jerrywang1201/TahoeOS/images/back.jpg

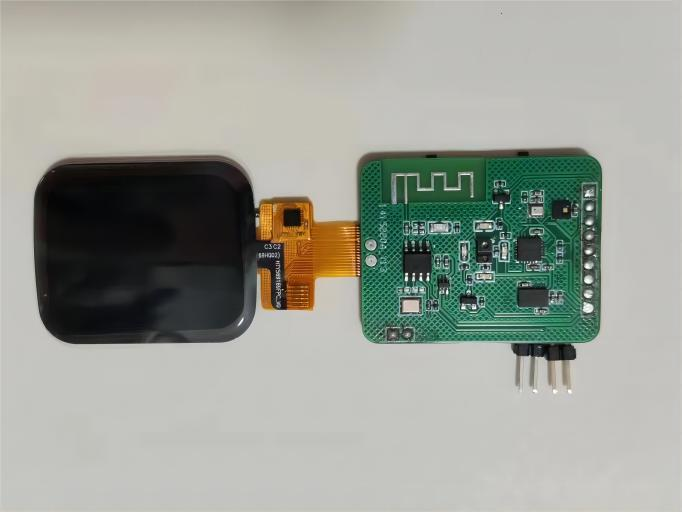
images/back.jpg
