jerrywang1201/TahoeOS/images/EM7028的测量曲线.jpg

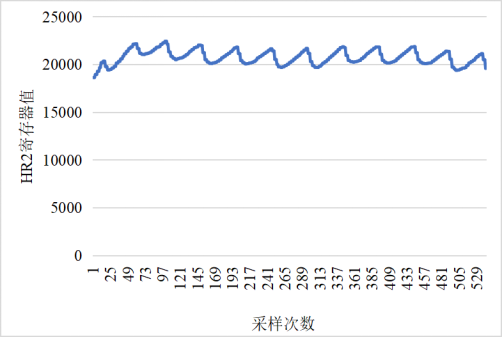
images/EM7028的测量曲线.jpg
