jerrywang1201/TahoeOS/images/front.jpg

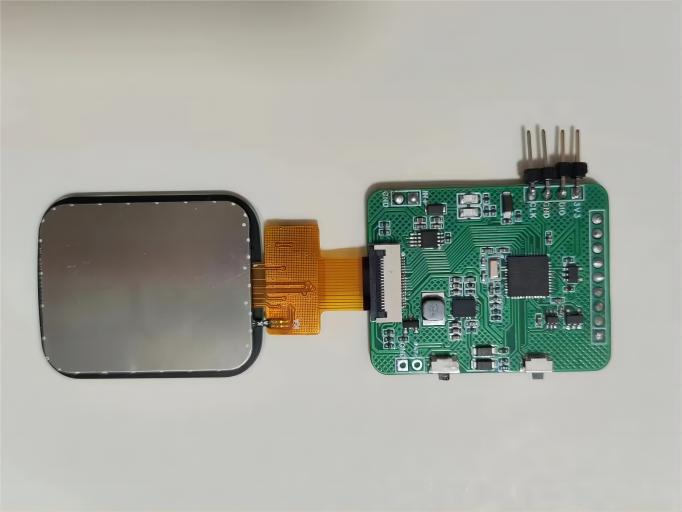
images/front.jpg
