jerrywang1201/TahoeOS/images/LVGL_sim.jpg

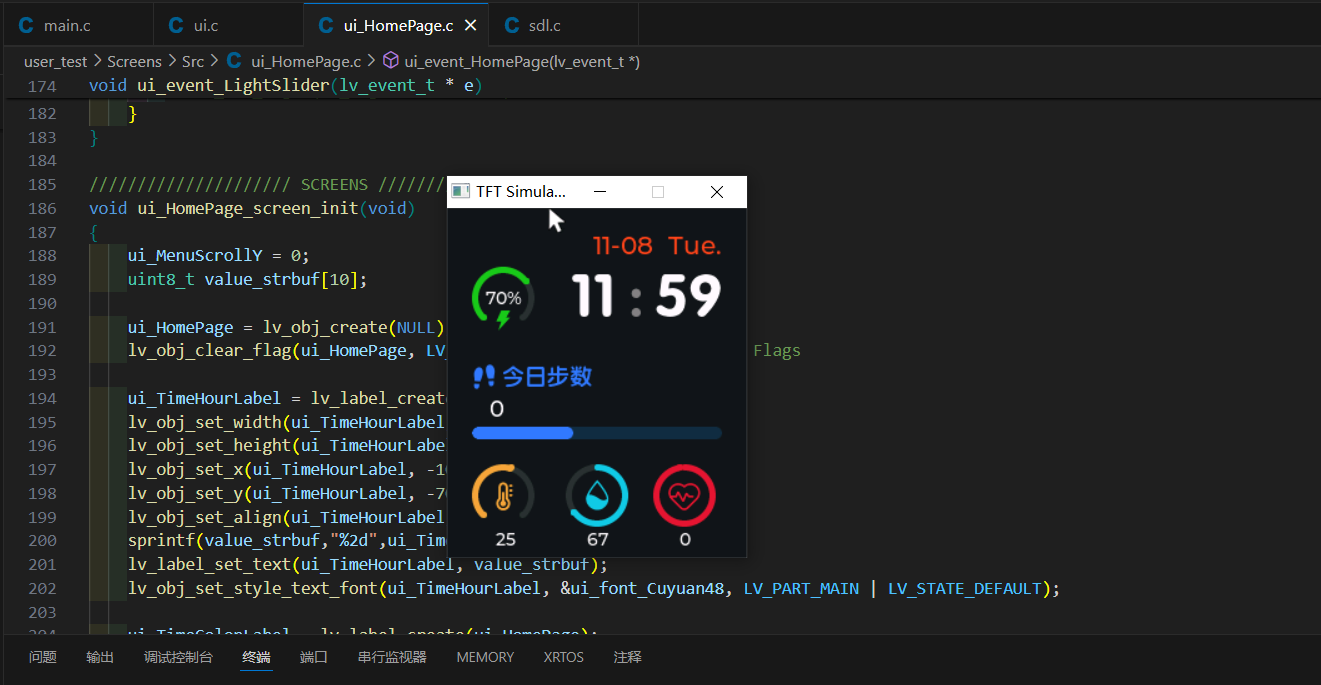
images/LVGL_sim.jpg
