jerrywang1201/TahoeOS/images/software structure.jpg

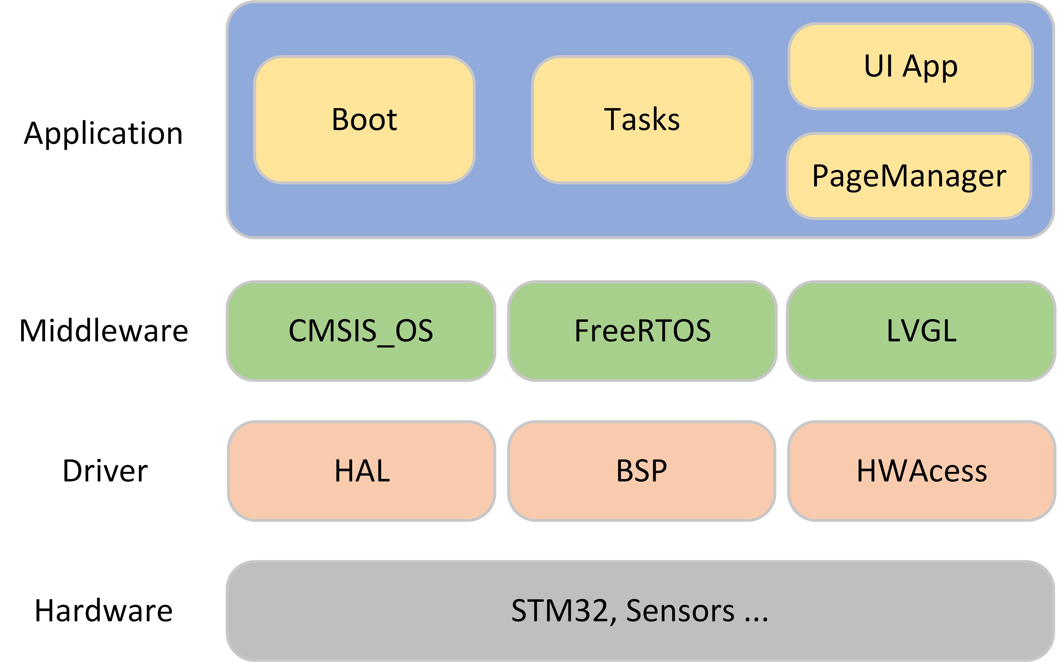
images/software structure.jpg
