jerrywang1201/TahoeOS/images/功能表.jpg

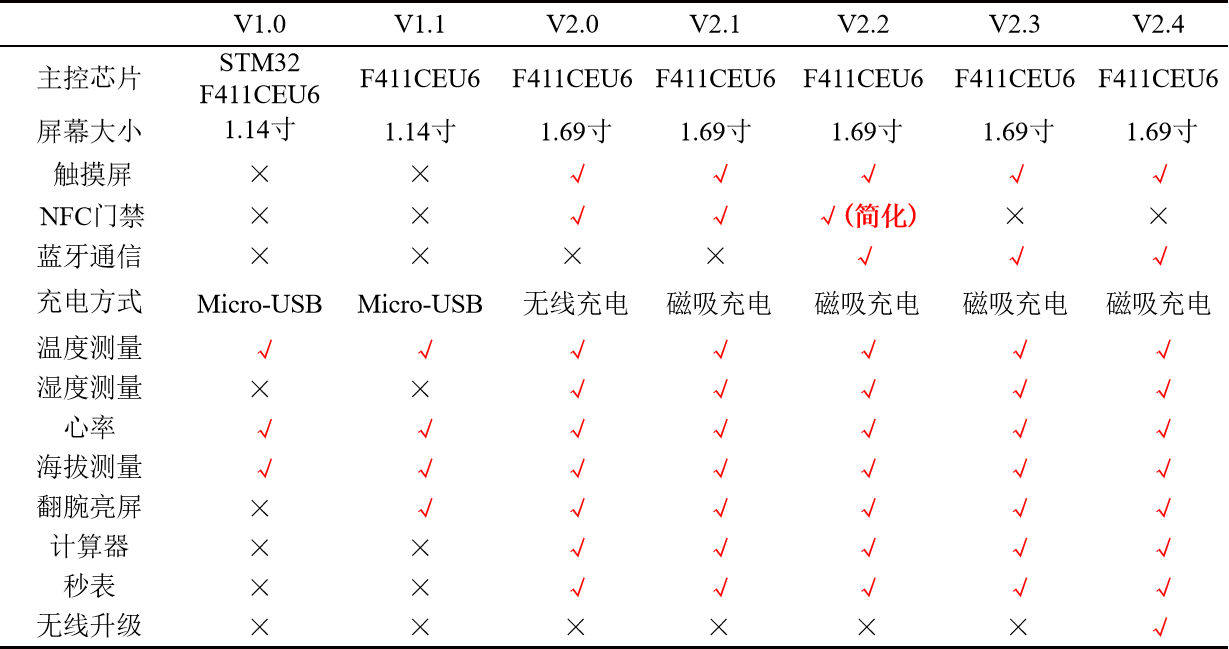
images/功能表.jpg
