jerrywang1201/TahoeOS/images/实物图2.png

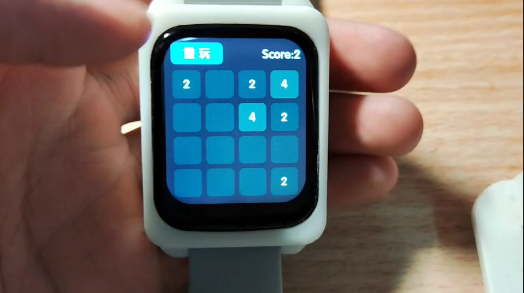
images/实物图2.png
