jerrywang1201/TahoeOS/images/实物图3.png

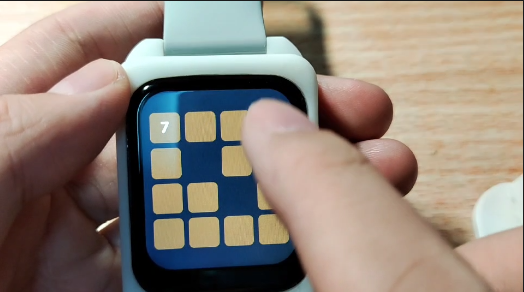
images/实物图3.png
