jerrywang1201/TahoeOS/images/心率实物图.png

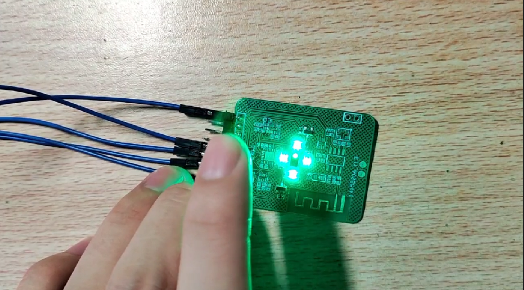
images/心率实物图.png
