jerrywang1201/TahoeOS/images/界面.jpg

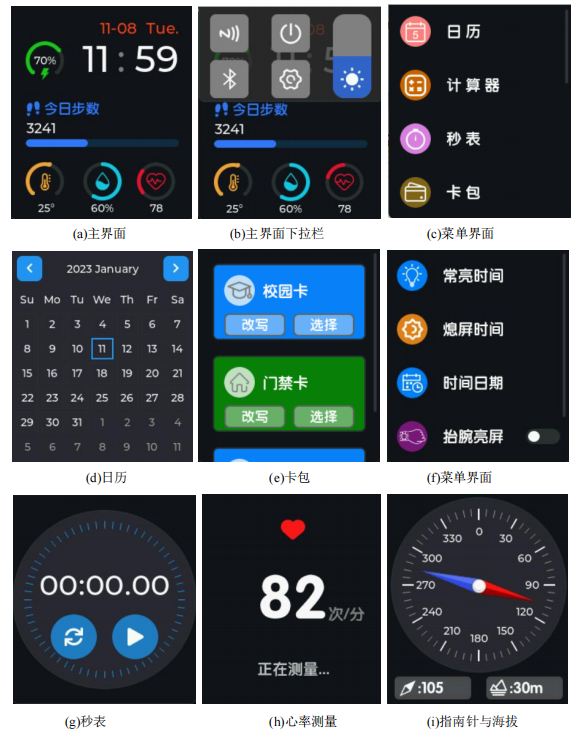
images/界面.jpg
