jerrywang1201/TahoeOS/images/计算.gif

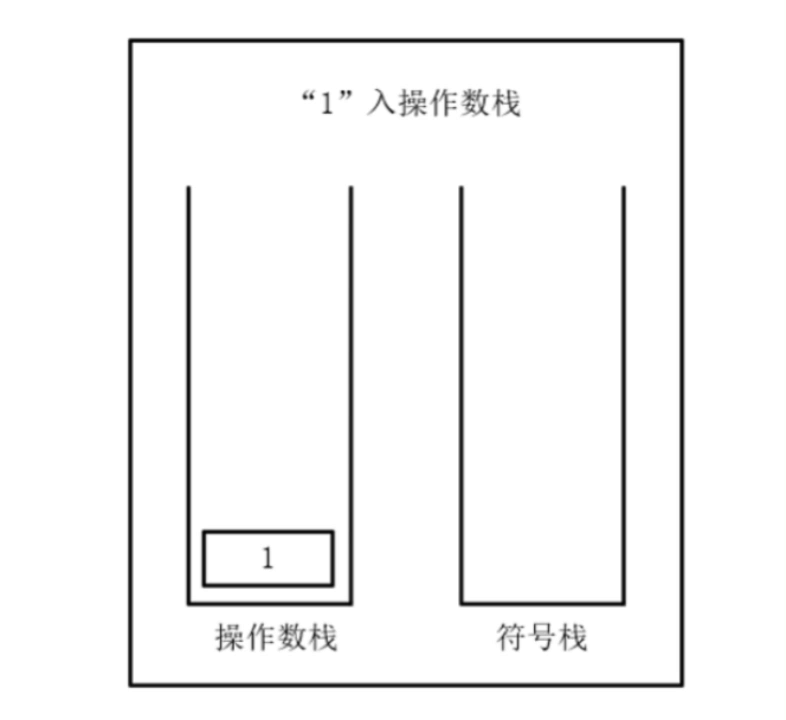
images/计算.gif
