jerrywang1201/TahoeOS/3D Modle/按键零件.STL

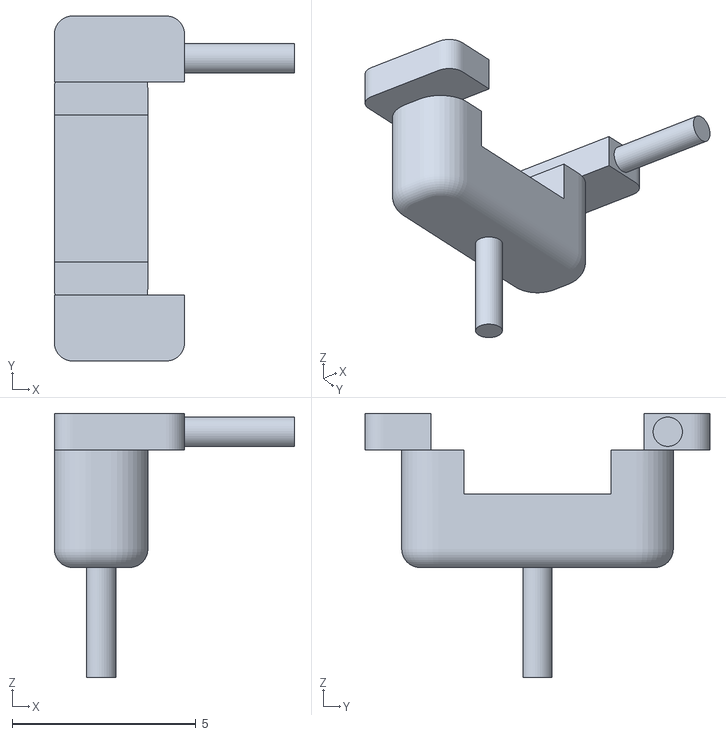
[picture p21: CAD file, 2025-12-08]
3D Modle/按键零件.STL
6.55 x 9.40 x 7.20
