jerrywang1201/TahoeOS/3D Modle/后壳零件.STL

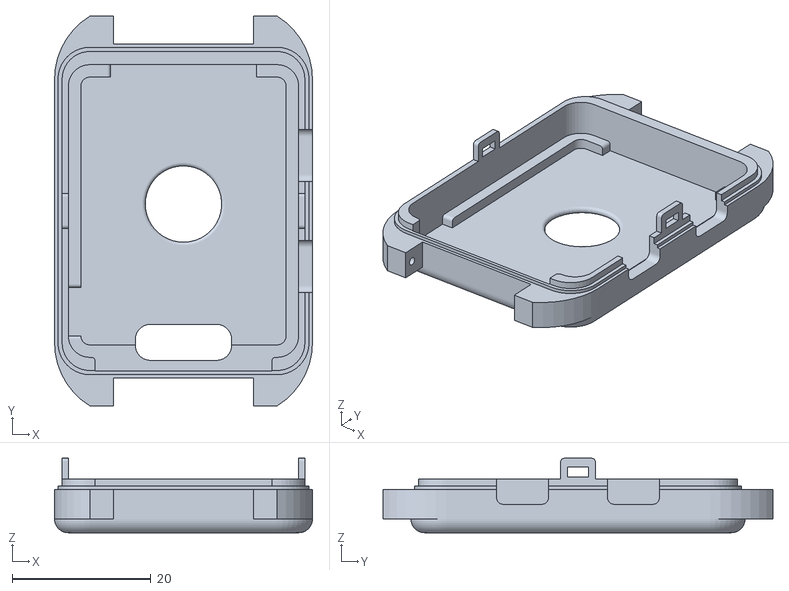
[picture p22: CAD file, 2025-12-08]
3D Modle/后壳零件.STL
37.2 x 56.2 x 10.8
