jerrywang1201/TahoeOS/3D Modle/前壳零件.STL

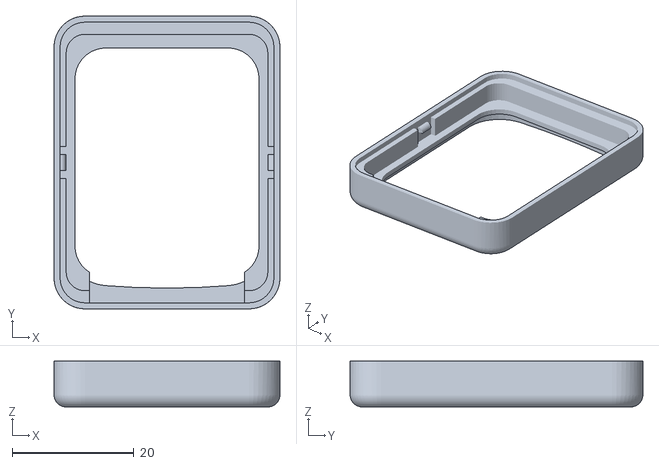
[picture p23: CAD file, 2025-12-08]
3D Modle/前壳零件.STL
37.2 x 48.2 x 7.55
