jerrywang1201/TahoeOS/Software/IAP_F411/Core/Src/main.c

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
/* Includes ------------------------------------------------------------------*/
#include "main.h"
#include "adc.h"
#include "spi.h"
#include "tim.h"
#include "usart.h"
#include "gpio.h"

/* USER CODE BEGIN Includes */
#include "menu.h"
#include "delay.h"
#include "lcd.h"
#include "lcd_init.h"
#include "power.h"
#include "key.h"
#include "KT6328.h"
#include <string.h>
#include <stdio.h>
/* USER CODE END Includes */


/* USER CODE BEGIN PV */

uint8_t boot_in_menu_flag = 0;

extern pFunction Jump_To_Application;
extern uint32_t JumpAddress;

/* USER CODE END PV */

void SystemClock_Config(void);
/* USER CODE BEGIN 0 */
static uint8_t App_Image_IsValid(uint32_t sp, uint32_t reset)
{
  const uint32_t ram_start = 0x20000000;
  const uint32_t ram_end = 0x20020000;
  const uint32_t flash_start = APPLICATION_ADDRESS;
  const uint32_t flash_end = USER_FLASH_END_ADDRESS;

  if (sp < ram_start || sp > ram_end)
  {
    return 0;
  }

  if ((reset & 0x1U) == 0U)
  {
    return 0;
  }

  reset &= ~0x1U;
  if (reset < flash_start || reset > flash_end)
  {
    return 0;
  }

  return 1;
}

/* USER CODE END 0 */

/**
  * @brief  The application entry point.
  * @retval int
  */
int main(void)
{
  /* USER CODE BEGIN 1 */
	SCB->VTOR = FLASH_BASE;
  /* USER CODE END 1 */

  /* MCU Configuration--------------------------------------------------------*/

  /* Reset of all peripherals, Initializes the Flash interface and the Systick. */
  HAL_Init();

  /* Configure the system clock */
  SystemClock_Config();

  /* Initialize all configured peripherals */
  MX_GPIO_Init();
  MX_USART1_UART_Init();
  MX_SPI1_Init();
  MX_TIM3_Init();
  MX_ADC1_Init();
  /* USER CODE BEGIN 2 */

	//sys delay
	delay_init();

  //key
	Key_Port_Init();

	//BLE
	KT6328_GPIO_Init();
	KT6328_Enable();
	
	//power GPIO使能和电池供电使能
	Power_Init();

	//PWM Start
	HAL_TIM_PWM_Start(&htim3, TIM_CHANNEL_3);

	//lcd
	LCD_Init();
	LCD_Fill(0, 0, LCD_W, LCD_H, BLACK);
	delay_ms(10);
	LCD_Set_Light(50);

  //开机启动时如果按下KEY1, 进入boot中IAP升级模式
  if(HAL_GPIO_ReadPin(KEY1_PORT, KEY1_PIN) == 0)
  {
		// 延时判断是否真的按下
    delay_ms(500);
    if(HAL_GPIO_ReadPin(KEY1_PORT, KEY1_PIN) == 0)
    {
      
      LCD_ShowString(72, LCD_H/2, (uint8_t*)"Bootload", WHITE, BLACK, 24, 0);//12*6,16*8,24*12,32*16
      LCD_ShowString(32, LCD_H/2+48, (uint8_t*)"OV-Watch V2.4.1", WHITE, BLACK, 24, 0);

			boot_in_menu_flag = 1;
			
      //go in boot menu
      FLASH_If_Init();
      Main_Menu();
    }
  }

  //如果没按下KEY1, 且有APP程序, 则运行APP, 没有APP则
  else
  {
    uint32_t data1, data2;
    char *str_flag;
    uint32_t address = 0x08008000; // Flash 中数据的起始地址

    // 读取地址为 0x08008000 的数据
    data1 = *(uint32_t *)address;

    // 读取地址为 0x08008004 的数据
    data2 = *(uint32_t *)(address + sizeof(uint32_t));

    // 将数据转换为字符数组
    char str1[5], str2[5];
    memcpy(str1, &data1, sizeof(data1));
    memcpy(str2, &data2, sizeof(data2));
    str1[4] = '\0';
    str2[4] = '\0';

    // 拼接两个字符数组
    char combined_str[9];
    strcpy(combined_str, str1);
    strcat(combined_str, str2);

    // 检查是否与 "APP FLAG" 相同
    if (strcmp(combined_str, "APP FLAG") == 0)
    {
        uint32_t app_sp = *(__IO uint32_t*) APPLICATION_ADDRESS;
        uint32_t app_reset = *(__IO uint32_t*) (APPLICATION_ADDRESS + 4);

        if (App_Image_IsValid(app_sp, app_reset))
        {
          // 如果相同则跳转
          printf("APP FLAG OK, jump to app\r\n");
          //user code here
          SysTick->CTRL = 0X00;//禁止SysTick
          SysTick->LOAD = 0;
          SysTick->VAL = 0;
          __disable_irq();

          //set JumpAddress
          JumpAddress = app_reset;
          /* Jump to user application */
          Jump_To_Application = (pFunction) JumpAddress;
          /* Initialize user application's Stack Pointer */
          __set_MSP(app_sp);
          Jump_To_Application();
        }
        else
        {
          LCD_ShowString(60, LCD_H/2, (uint8_t*)"Bad App!", WHITE, BLACK, 24, 0);
          LCD_ShowString(32, LCD_H/2+48, (uint8_t*)"Please Download", WHITE, BLACK, 24, 0);
          HAL_Delay(1000);
        }
    }
		// no legal APP 
		else
		{
			LCD_ShowString(74, LCD_H/2, (uint8_t*)"No App!", WHITE, BLACK, 24, 0);//12*6,16*8,24*12,32*16
      LCD_ShowString(32, LCD_H/2+48, (uint8_t*)"Please Download", WHITE, BLACK, 24, 0);
			HAL_Delay(1000);
		}
  }


  /* USER CODE END 2 */

  /* Infinite loop */
  /* USER CODE BEGIN WHILE */
  while (1)
  {
    /* USER CODE END WHILE */

    /* USER CODE BEGIN 3 */
		printf("run in boot while(1)\r\n");
    printf("there is no legal APP\r\n");
		HAL_Delay(500);
		Power_DisEnable();
  }
  /* USER CODE END 3 */
}

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
