jerrywang1201/TahoeOS/(commit log)

2025-12-08 Initial commit: Start of TahoeOS Project
    [OV-Watch_V2.4_LCProject_2024-05-25.epro, 前壳零件.STL, 后壳零件.STL, 按键零件.STL]
2026-01-13 Fixed: uninit values not can be valued after init
    [Drill_NPTH_Through.DRL, Drill_PTH_Through.DRL, Drill_PTH_Through_Via.DRL, Gerber_BoardOutlineLayer.GKO, Gerber_BottomLayer.GBL, Gerber_BottomPasteMaskLayer.GBP, Gerber_BottomSilkscreenLayer.GBO, Gerber_BottomSolderMaskLayer.GBS]
2026-01-14 To fix the hang risk caused by the unimplemented EXTI2 interrupt, EXTI2_IRQHandler has been added to prevent the system from entering a default infinite loop when the charging pin triggers an interru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
2026-01-14 Add a vector table validity check before redirecting to the app (SP must be in RAM, and the Reset handler must be in the app flash memory and be a Thumb address).
    [main.c]
2026-01-14 PowerCalculate returns 0 by default at low voltages to avoid uninitialized values.
    [power.c]
